pearsondesign/pearsondesign.github.io/README.md

# Pearson Design

This is the source code for the [Pearson Design](pearsondesign.co) website, built with Docusaurus.
