pearsondesign/pearsondesign.github.io/docs/Electronics/assets/Thumb.png

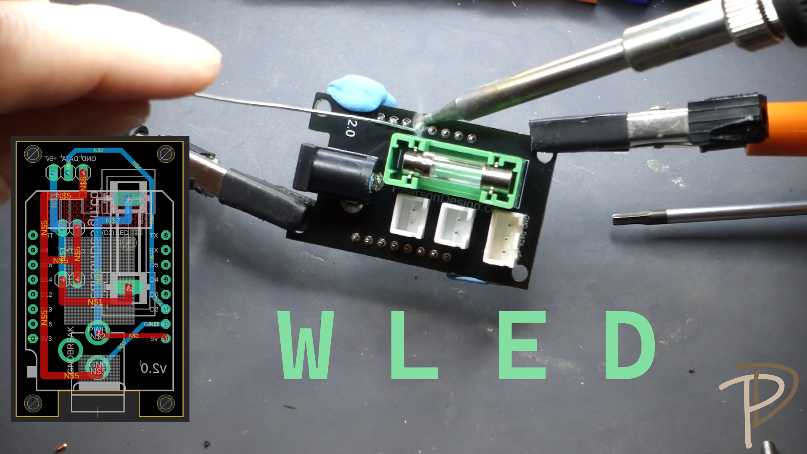
docs/Electronics/assets/Thumb.png
