pearsondesign/pearsondesign.github.io/docs/Electronics/assets/WLedCaseHolder.3mf

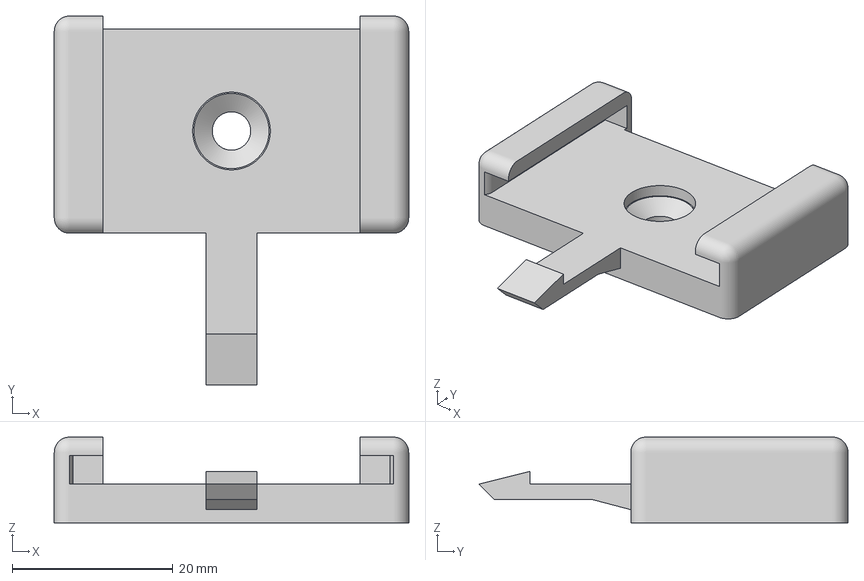
[picture p6: CAD file, 2023-12-18]
docs/Electronics/assets/WLedCaseHolder.3mf
44.0 x 45.8 x 10.7 mm
