pearsondesign/pearsondesign.github.io/docs/Electronics/assets/WLedCaseSpacer.3mf

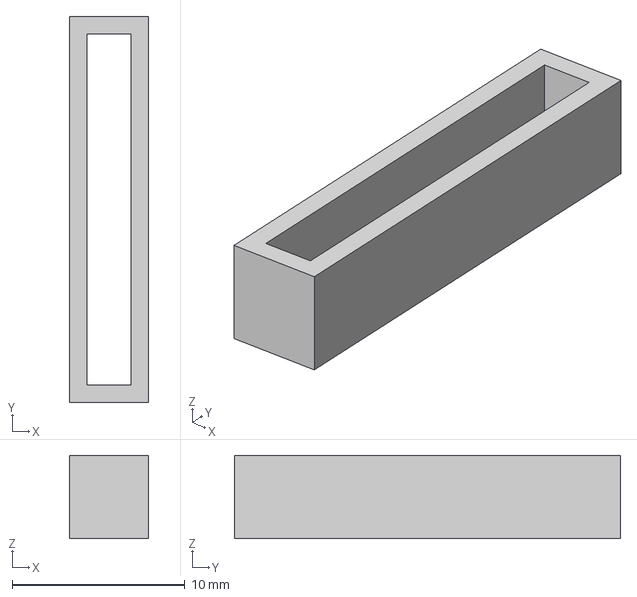
[picture p7: CAD file, 2023-12-18]
docs/Electronics/assets/WLedCaseSpacer.3mf
4.57 x 22.4 x 4.83 mm
