pearsondesign/pearsondesign.github.io/docs/Electronics/assets/WLedCaseBottom.3mf

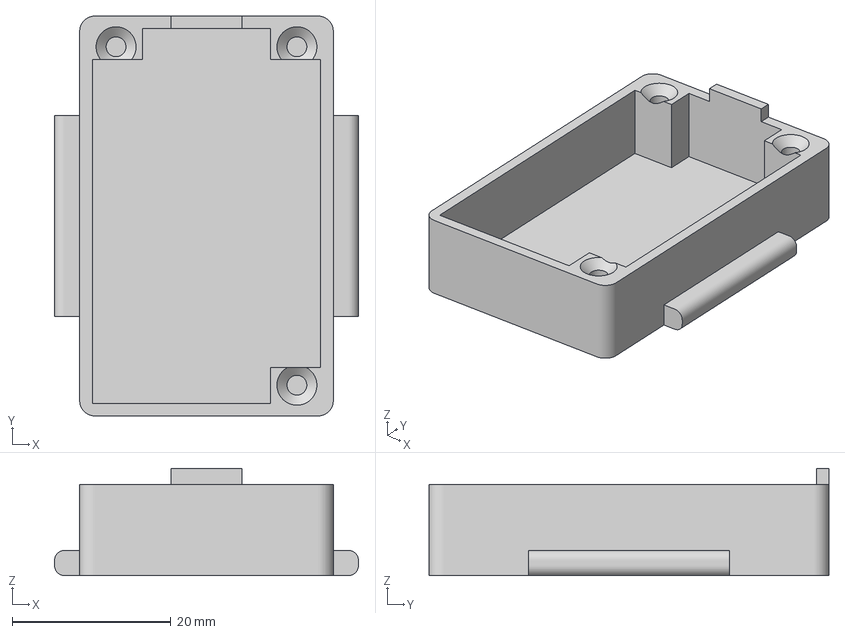
[picture p8: CAD file, 2023-12-18]
docs/Electronics/assets/WLedCaseBottom.3mf
38.3 x 50.4 x 13.5 mm
