pearsondesign/pearsondesign.github.io/docs/Electronics/assets/WLedCaseTop.3mf

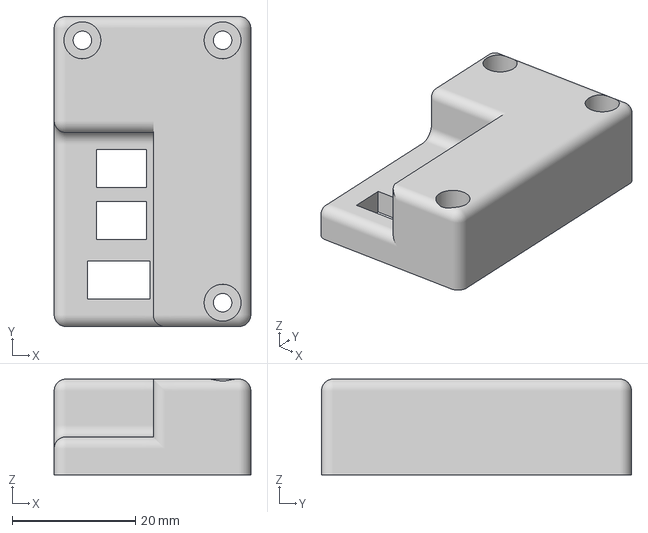
[picture p9: CAD file, 2023-12-18]
docs/Electronics/assets/WLedCaseTop.3mf
32.0 x 50.4 x 15.6 mm
