pearsondesign/pearsondesign.github.io/(commit log)

2023-12-18 wled doc
    [WLedCaseBottom.3mf, WLedCaseHolder.3mf, WLedCaseSpacer.3mf, WLedCaseTop.3mf]
2023-12-18 Fixed links, added more info
    [WLedCaseBottom.3mf, WLedCaseHolder.3mf, WLedCaseSpacer.3mf, WLedCaseTop.3mf]
